WimHager/Kedok/Docs/Wireing-Unit.png

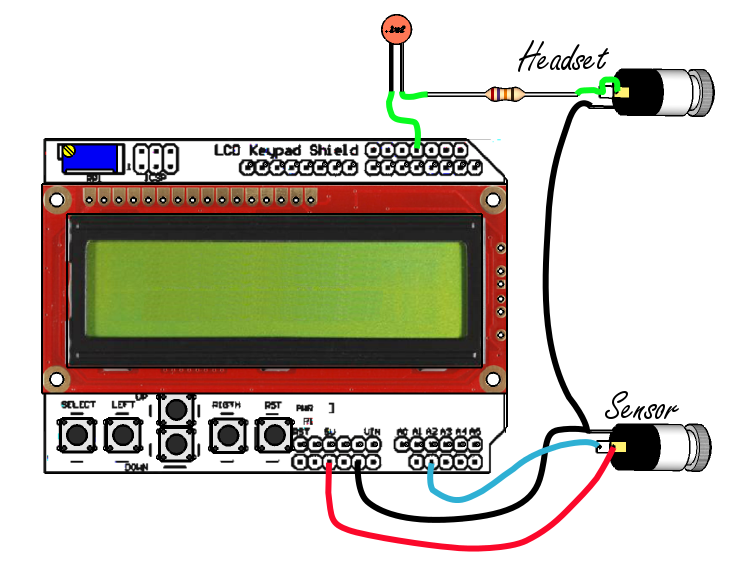
Docs/Wireing-Unit.png
