WimHager/Kedok/CAD/Lamp Laser Adjuster/LaserCap.jpg

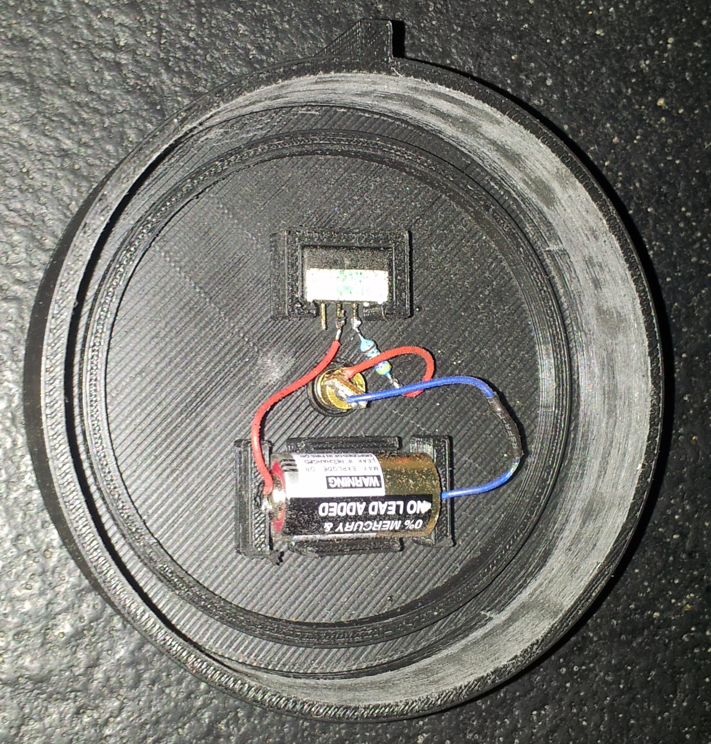
CAD/Lamp Laser Adjuster/LaserCap.jpg
