WimHager/Kedok/README.md

# Kedok
Audio aiming device
Kedok a device to build an acoustical aiming scope for visual impaired sport shooters, better known as the SH3 class. 
http://acoustic-shooting.blogspot.nl
