WimHager/Kedok/CAD/Lamp Laser Adjuster/Cap on lamp.jpg

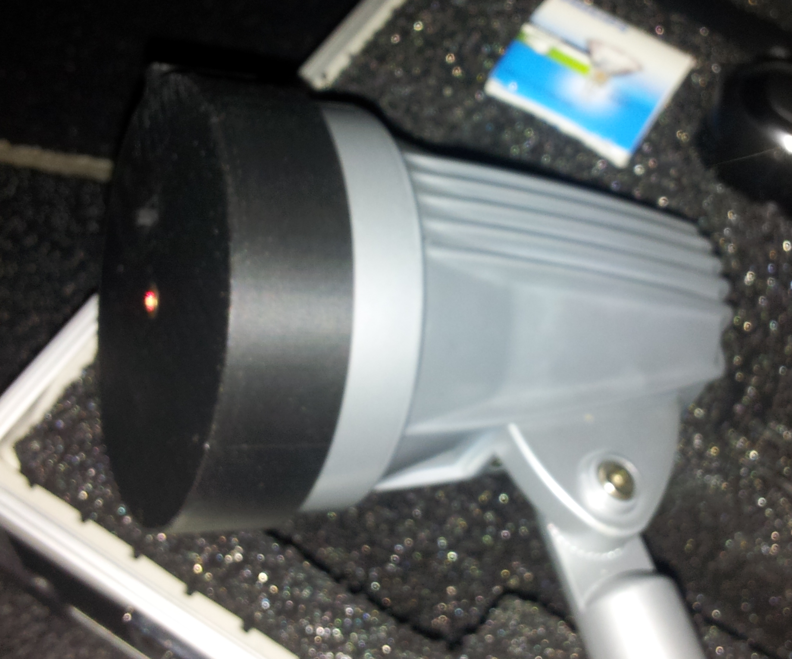
CAD/Lamp Laser Adjuster/Cap on lamp.jpg
