WimHager/Kedok/CAD/Lamp Laser Adjuster/Laser Cap.png

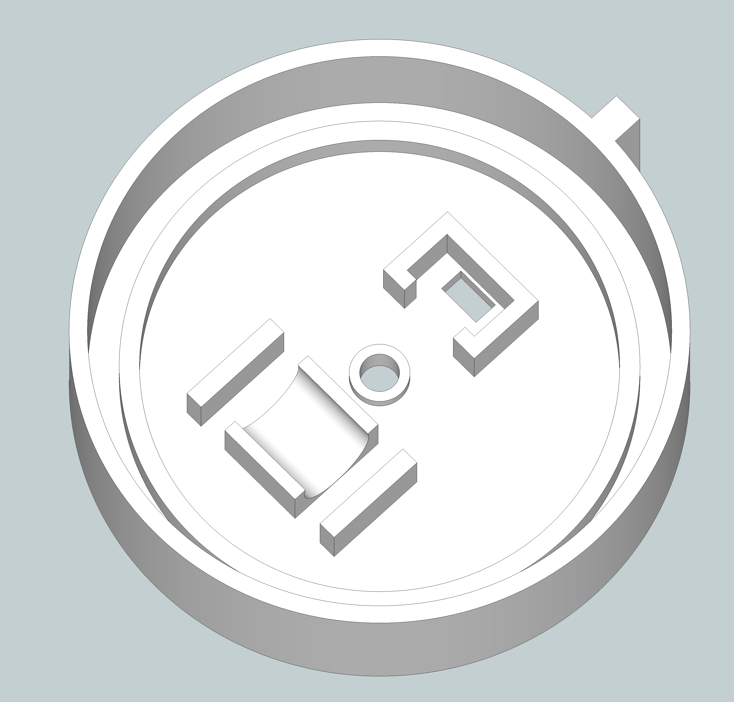
CAD/Lamp Laser Adjuster/Laser Cap.png
