WimHager/Kedok/Docs/Scope iso view.png

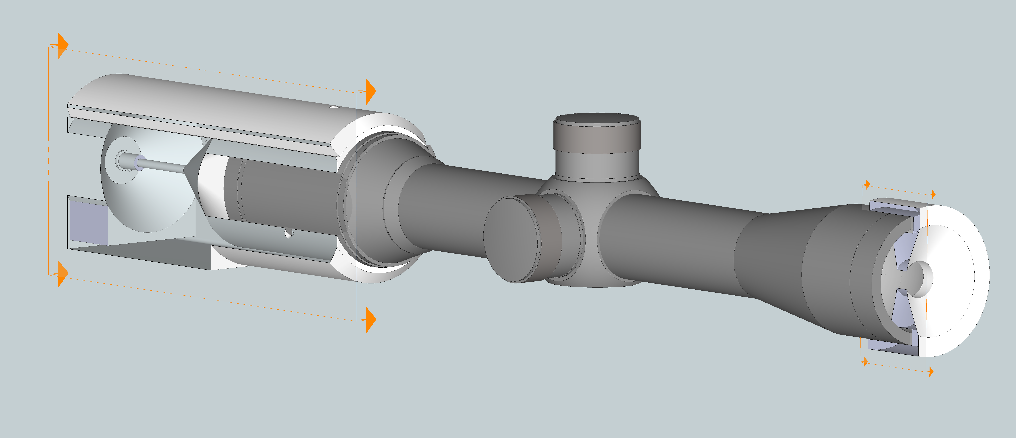
Docs/Scope iso view.png
