WimHager/Kedok/Docs/Unit 800.png

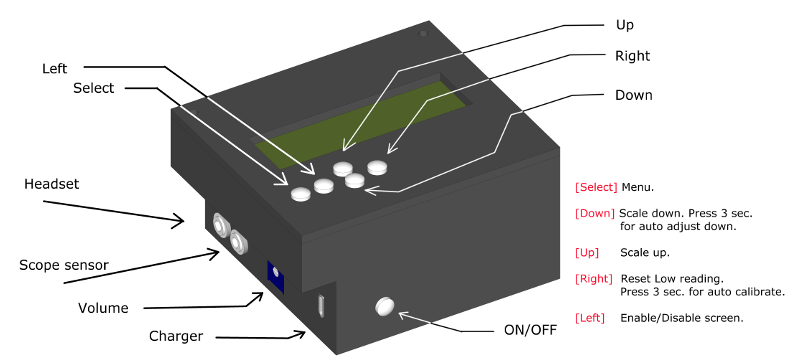
Docs/Unit 800.png
