WimHager/Kedok/Docs/Wireing-Adaptor..png

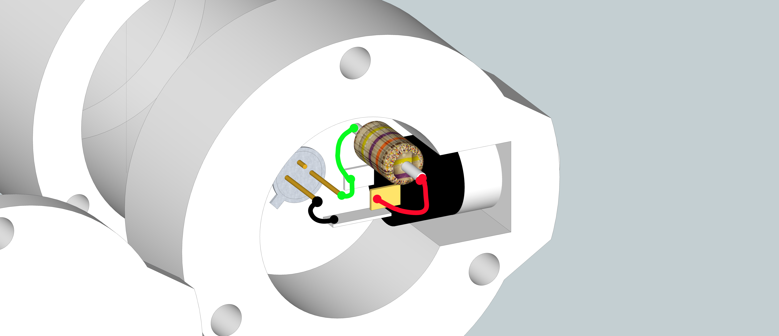
Docs/Wireing-Adaptor..png
