WimHager/Kedok/CAD/Housing/STL/Buttons top.stl

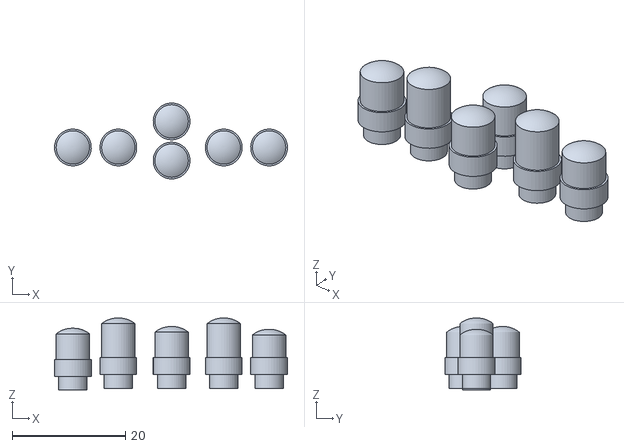
[picture p8: CAD file, 2015-12-07]
CAD/Housing/STL/Buttons top.stl
41.1 x 13.4 x 12.7
