WimHager/Kedok/CAD/Scope Adaptor/Hawke 4x32/STL/HawkeAdaptor 2.00 Vantage Tube.stl

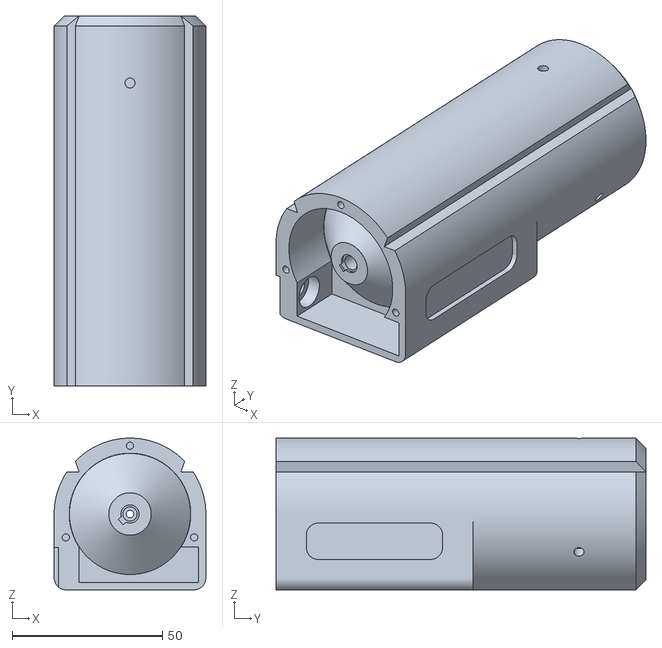
[picture p9: CAD file, 2015-12-10]
CAD/Scope Adaptor/Hawke 4x32/STL/HawkeAdaptor 2.00 Vantage Tube.stl
50.5 x 123.0 x 50.5
