WimHager/Kedok/CAD/Housing/STL/Bottom.stl

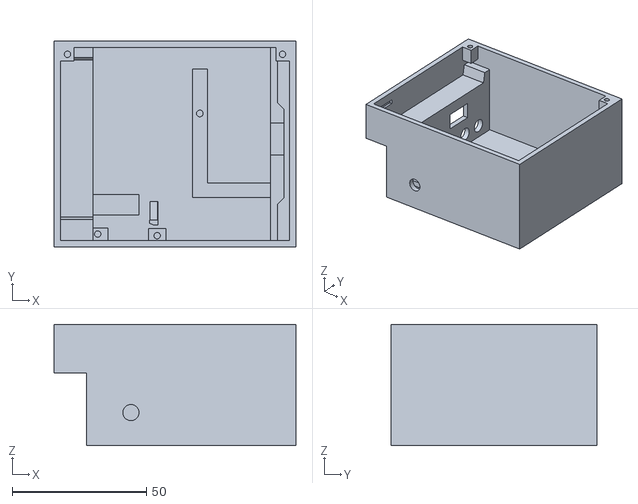
[picture p10: CAD file, 2015-12-07]
CAD/Housing/STL/Bottom.stl
90.0 x 76.7 x 45.1
