WimHager/Kedok/CAD/Scope Adaptor/Hawke 4x32/STL/HawkeAdaptor 2.00 Vantage Back Cap.stl

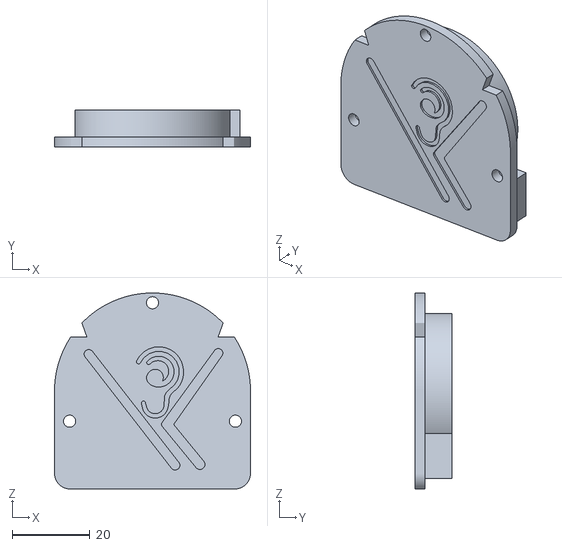
[picture p11: CAD file, 2015-12-10]
CAD/Scope Adaptor/Hawke 4x32/STL/HawkeAdaptor 2.00 Vantage Back Cap.stl
50.5 x 9.53 x 50.5
