WimHager/Kedok/CAD/Housing/STL/Charger mount.stl

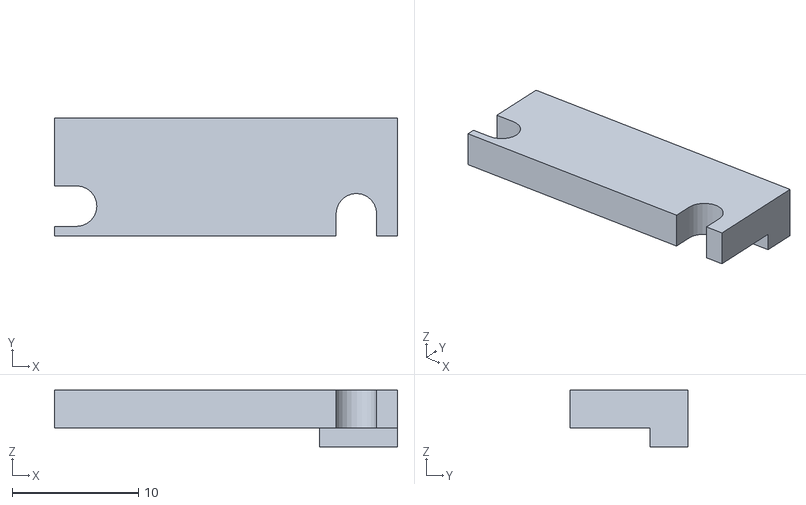
[picture p12: CAD file, 2015-12-07]
CAD/Housing/STL/Charger mount.stl
27.1 x 9.30 x 4.50
