WimHager/Kedok/CAD/Housing/STL/Top.stl

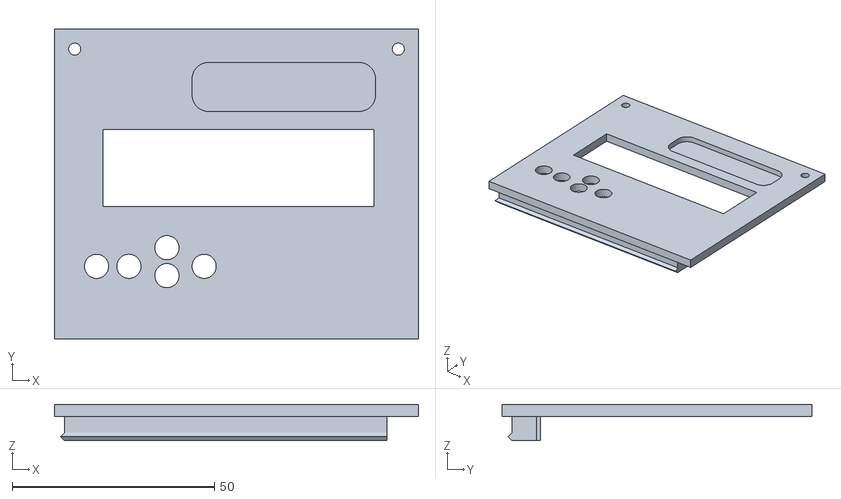
[picture p13: CAD file, 2015-12-07]
CAD/Housing/STL/Top.stl
90.0 x 76.7 x 9.00
