WimHager/Kedok/CAD/Housing/STL/Button on-off.stl

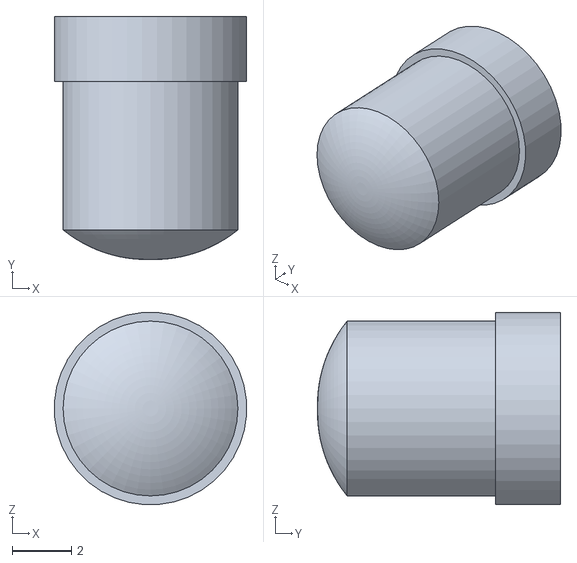
[picture p14: CAD file, 2015-12-07]
CAD/Housing/STL/Button on-off.stl
6.49 x 8.20 x 6.49
