WimHager/Kedok/CAD/Housing/STL/Programmer lid.stl

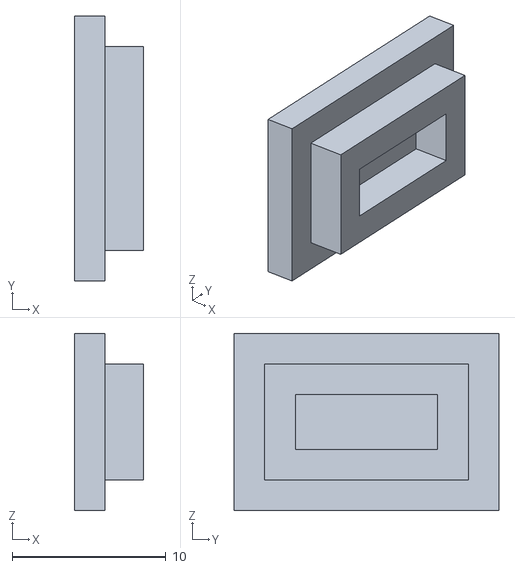
[picture p15: CAD file, 2015-12-07]
CAD/Housing/STL/Programmer lid.stl
4.50 x 17.2 x 11.6
