WimHager/Kedok/(list of files, cad)

Other CAD files:
CAD/Lamp Laser Adjuster/Laser Cap.skp
CAD/Scope Adaptor/Hawke 4x32/Hawke 4x32 Vantage.skp
CAD/Scope Adaptor/Hawke 4x32/HawkeAdaptor 2.00 Sport HD.skp
CAD/Scope Adaptor/Hawke 4x32/HawkeAdaptor 2.00 Vantage no logo.skp
CAD/Scope Adaptor/Hawke 4x32/HawkeAdaptor 2.00 Vantage.skp
CAD/Scope Adaptor/Hawke 4x32/HawkeAdaptor 2.00.skp
CAD/Scope Adaptor/Hawke 4x32/HawkeAdaptor Diaphragm Sport HD.skp
CAD/Scope Adaptor/Tasco 4x20/Adaptor 2.10 (oud model 4x20).skp
CAD/Scope Adaptor/Tasco 4x20/Adaptor 2.20.skp
CAD/Scope Adaptor/Tasco 4x20/ScopeAdjuster.skp
CAD/Suitcase/Inlay.skp
CAD/Tripod/LampMount.skp
CAD/Tripod/TrafoMount.skp
CAD/Tripod/TrafoMountVertical.skp
