WimHager/Kedok/Docs/Manual/Beschrijving van het Kedo kastje-5.0.odt

Beschrijving van de Kedok unit.

Het kastje heeft een afmeting van 10 bij 7 bij 5 centimeters.

Wat er op de bovenkant zit:

In het midden zit een LCD scherm en er zitten 5 knoppen aan de linker onderzijde.

Met de meest linkse knop komt in in het menu voor de instellingen.

Rechts hiervan zit de knop om de scherm updates uit of aan te zetten.

Hiernaast zitten twee knoppen Up en Down, met deze knoppen kunt het venster waarin de sensor werkt verlagen of verhogen.

De meest rechtse knop is om de laagste waarde in het scherm te resetten, druk je 3 seconden op de knop dan start het automatisch kalibreren.

Aan de voorzijde zit maar één knop voor aan en uit, als je het kastje aan zet zul je een melodie horen.

Linker kant:

Van voor naar achteren, de eerste aansluiting is een mini USB aansluiting om de accu op te laden.

Hierachter zit een klein vierkant, hiermee kun je het volume regelen. Dit kun je bedienen met een kleine schroevendraaier of met je nagel.

Vervolgens zit hierachter een 3,5mm jack plug voor de sensor kabel.

De laatste aansluiting is eveneens een 3,5mm jack plug voor de koptelefoon.

En ja, ik weet dat een LCD scherm geen enkel nut heeft voor iemand die niet kan zien. Maar zit daar niet over in, je hebt het niet nodig.
