WimHager/Kedok/Docs/Manual/Description of the Kedok unit-5.0.odt

Description of the Kedok unit.

The unit is a box with a size of 10 by 7 by 5 centimetres

What you can find on the top of the box:

There is a LCD display at the centre.

And you have 5 buttons, at the left bottom.

The most left button is to enter the menu for settings.

Right next button is used to enable or disable the LCD screen sensor reading updates.

Then there are two buttons Up and down. these buttons are used to increase or decrease the sensor reading.

The most right button is to reset the lowest reading in the display.

If you press this button for 3 seconds, automatic calibration of the unit starts.

The front:

There is only one button to switch the unit on and off, if you switch it on you will hear a melody.

Left side:

Reading it from front to back.

First there is a mini USB connector for charging the unit battery.

Behind this is a small square here you can set the unit volume, use a small screwdriver or you nail to adjust.

Next there is a 3.5mm jack connector for the sensor cable.

The last one is also a 3.5mm jack for the headphones.

And yes I know, a LCD display makes no sense if you can't see, but don't worry you won't need it.
