WimHager/Kedok/Docs/Tripot setup.png

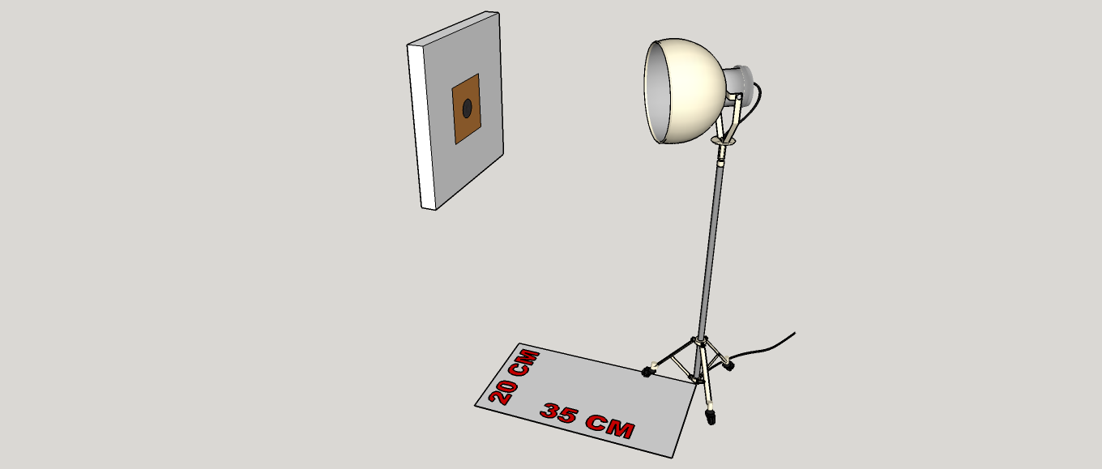
Docs/Tripot setup.png
