WimHager/Kedok/Software/Dev/Kedok-V3.3.ino

/*
    Kedok (audio aiming device), Copyright 2015 Wim Hager
    Kedok is distributed under the terms of the GNU GPL
    
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
    12/6/2015 This software is started by Wim Hager email: wim@mowbot.nl
              CAD and 3D printworks Jan Stinissen

To Do:
 Battery level check?
 ShowLCD bug. no clear
 Reset all if version updated
 Better Auto adjust
 Full test of Curve parameter
 Tons of testing for the new DDS module
 //Rollback from 3v3 mod. Does not work well with LCD keypad output on A0
 //No need to save logmode in eeprom
 //Logmode in display Only in No Display mode
 //Reverse Pitch
 //Save Setting as structure???
 //Always Sound. Added not tested yet!!
 //Removed "Always sound" no-one liked it.
 //new inrange for bar reading
 //Better way to find the target card. Idea:  if sensor-read < Min + 2 x Windowsize set sensor window twice the size
 //SetSensorWindowToLowestRead()
 //Make WordToStr better so it fits all sizes
 //Bug. while adjusting the MIN or UP parameter while shooting screen dos not return to running if Display is off.
 //Menu option to set auto adjust window, Benjamin prefers a window of 100 and a gain of -3
 //Test if gain is reverse. Negative etting gives a positve gain. 
 //Sound during auto adjust wait.
 //More info if display readings. Sensor Min Max Lowest
 //Auto adjust auto stop if no lower reading  within 12 sec.
 //Show settings instead of Running ... if displaymode is off
 //Logging
 
 V2.00 18-4-2015
 Compiled with 1.0.5
 New: Using NewTone Library
 25-4-2015 Changed defaults for high low tone
 V2.10 27-4-2015
 27-4-2015 Added shift sensor window while running Up/Down key
 29-4-2015 Speed up the main loop by one readkey.
 V3.00 3-5-2015
 Added Auto adjust
 New Beep and Keypressed function
 23-5-2015 Added some text in Auto adjust
 V3.1 26-6-2015
 Gain is replaced by Curve for better understanding.
 Added Auto adjust window size. Default 200
 28-7-2015  Made SensorPin a variable
 30-7-2015  Added option to enable Always sound
 1-9-2015   Always sound bug, was not set in menu
 24-10-2015 Screen bug update in no Dispaly mode
 26-10-2015 Removed cracking sound aiming near bulls-eye (removed inrange low value check)
 28-10-2015 Window Dec Inc set to 10
 28-10-2015 Redo of show status screen if display is disabled.
 31-10-2015 Added Owner name, shown when booting.
 02-11-2015 Added auto set Min value with a warning by pressing 3 sec down key
 V3.2 04-11-2015
 06-11-2015 New Kernel for better target card find
 06-11-2015 Removed Always sound, no-one liked it.
 14-11-2015 Added Logging.
 14-11-2015 Added Reverse Pitch
 14-11-2015 EE-Prom settings are saved as a Struct obj now
 25-11-2015 Compiled with 1.6.5 now
 28-11-2015 Roll back:  Added option to use 3.3V ref for optosensor. Enabled if data pin 0 is grounded.
 V3.3 04-12-2015
 04-12-2012 Added code for DDS 8950 chip as compiler option.
 */

//Note Audio pin 3, 82 Ohm and 470N in serie
//Opto resistor 68K
//Loops free running 4150 with sound 925

//#define DEBUG
#define DDS8950

#include <LiquidCrystal.h>
#ifdef DDS8950
  #include <DDS.h> 
#else   
  #include <NewTone.h>
#endif  
#include <EEPROM.h>
#include <LcdBarGraph.h>
LiquidCrystal lcd(8, 9, 4, 5, 6, 7);
LcdBarGraph   lbg(&lcd, 16, 0, 0);
int Melody[] = { 
  262, 196, 196, 220, 196, 0, 247, 262 };
int NoteDurations[] = { 
  4, 8, 8, 4, 4, 4, 4, 4 };
  
 struct SettingsObj {
  word MinValue;
  word MaxValue;
  byte ThresholdWindow;
  byte Curve;
  byte PitchRev;
  word AutoAdjustWindow;
  word LowTone;
  word HighTone;
  byte NotInUse;
  byte Display;
};  

const   char      Version[5]="3.30";
const   char      Owner[10]=     "";
const   byte      None=           0; 
const   byte      Select=         1;
const   byte      Left=           2;
const   byte      Down=           3;
const   byte      DownLong=      13;
const   byte      Up=             4; 
const   byte      Right=          5;
const   byte      RightLong=     15;
const   byte      Value=          1;
const   byte      Bar=            2;
const   boolean   Disable=     true;
const   boolean   Enable=     false;
const   char      EmptyLine[17]=  "                ";

#ifdef DDS8950 
 const int        W_CLK=  0;       // Pin 0 - connect to AD9850 module word load clock pin (CLK)
 const int        FQ_UD=  1;       // Pin 1 - connect to freq update pin (FQ)
 const int        DATA=   2;       // Pin 2 - connect to serial data load pin (DATA)
 const int        RESET=  3;       // Pin 3 - connect to reset pin (RST).
 DDS dds(W_CLK, FQ_UD, DATA, RESET);
#endif
  
word    MinValue=                100;
word    MaxValue=                800;
word    LowTone=                 100; 
word    HighTone=               1750;
byte    Curve=                     0;
byte    PitchRev=              false;  
word    AutoAdjustWindow=        200;
word    DispUpdTime=            1000; //1 sec Screen update 
byte    Display=                   0;
byte    ThresholdWindow=         150;
byte    LogMode=                   0;
word    LogCounter=                0;
byte    NotInUse=                  0; //For future use
byte    LogBufferStart=           30; 
word    LogUpdTime=              250; //4 times a second for 1000 values about 4 Min. logging 
byte    ResetAll=                  0;
byte    AudioPin=                  3;
byte    SensorPin=                A1;
word    AutoAdjustGetReadyTime= 2000; // 20 Seconds
char    *DisplayType[]= {"None", "Value",  "Bar"};
char    *YesNoArr[]=    {"N", "Y"};
char    *LoggingModes[]={"Off", "On", "Play"};

long    PrevDispTime;
long    PrevLogTime;
word    Reading;
word    AudioTone;
word    LowestReading;
word    WarningReading;
byte    KeyPressed;

//Debug params
#ifdef DEBUG
word    LoopCounter; 
#endif  

float fscale( float originalMin, float originalMax, float newBegin, float newEnd, float inputValue, float Curve){
  float   OriginalRange=    0;
  float   NewRange=         0;
  float   zeroRefCurVal=    0;
  float   normalizedCurVal= 0;
  float   rangedValue=      0;
  boolean invFlag=          0;

  Curve= 0-Curve; //Make Curve negative
  Curve= (Curve * -.1) ; 
  Curve= pow(10, Curve);
  if (inputValue < originalMin) inputValue= originalMin;
  if (inputValue > originalMax) inputValue = originalMax;
  OriginalRange = originalMax - originalMin;
  if (newEnd > newBegin) NewRange= newEnd - newBegin;
  else{
    NewRange= newBegin - newEnd; 
    invFlag= 1;
  }
  zeroRefCurVal= inputValue - originalMin;
  normalizedCurVal=  zeroRefCurVal / OriginalRange;  
  if (originalMin > originalMax ) return 0;
  if (invFlag == 0) rangedValue=  (pow(normalizedCurVal, Curve) * NewRange) + newBegin;
  else rangedValue=  newBegin - (pow(normalizedCurVal, Curve) * NewRange); 
  return rangedValue;
}

void Reset() {
  asm volatile ("  jmp 0");
}  

word ReadValue() {
  return analogRead(SensorPin);
}

void PlayTone(word Pitch, word Duration) {
  #ifdef DDS8950
     if (Duration > 0) {
        dds.setFrequency(Pitch);
        delay(Duration);
        dds.setFrequency(0);
     }else dds.setFrequency(Pitch);   
  #else
     if (Pitch > 0) NewTone(AudioPin, Pitch, Duration);
     else noNewTone(AudioPin);  
  #endif   
}

void Beep(byte Beeps, word Tone) {
  for (byte X=0; X<Beeps; X++) {
    PlayTone(Tone,200);
    delay(400);
  }
}

void PlayMelody() {
  for (int ThisNote= 0; ThisNote < 8; ThisNote++) {
    int NoteDuration = 1000/NoteDurations[ThisNote];
    #ifdef DDS8950
      PlayTone(Melody[ThisNote]*5, NoteDuration); // Play thisNote at full volume for noteDuration in the background.
    #else  
      PlayTone(Melody[ThisNote], NoteDuration);
    #endif   
    delay(NoteDuration * 4 / 3); // Wait while the tone plays in the background, plus another 33% delay between notes.
  }
}

void LowReadWarning() {
    PlayTone(0,0); // Turn off the tone.
    WarningReading= Reading;
    lcd.clear();
    ShowLCD("Lower Min Value!",0,true);
    Beep(3,300);
    if (!Display) ShowStatusLCD();
}  

String WordToStr(word Inp, byte Size) {
  String Str;
  for (byte C= 0; C<Size; C++) Str+= "0";
  String WordStr= (String)Inp;
  byte Len= WordStr.length();
  for (byte C= 0; C<Len; C++) Str[C+Str.length()-Len]= WordStr[C];
  return Str; 
}  

boolean InRange() {
  return ((Reading > MinValue) && (Reading < MaxValue));
}

void StopLogging() {
   LogMode= 0;
   LogCounter= 0;
   lcd.clear();
   ShowLCD("Loggin stopped.",0,true);
   Beep(2,300);
   if (!Display) ShowStatusLCD();
}  

void WriteLog(word Value) {
  if ((millis()-PrevLogTime) > LogUpdTime) {
    if (LogCounter < 1000) {
       EEPROM.update(LogCounter+LogBufferStart, map(Value, MinValue, MaxValue, 0, 255));
       LogCounter++;
       PrevLogTime= millis();
    }else StopLogging();
  }  
 }  

void OutputLog() {
  for (int C= 20; C<1000; C++) { 
    Serial.println(EEPROM.read(C));
  }
  StopLogging();
}  

void MoveSensorWindow(int Val) {
  MinValue= MinValue + Val;
  MaxValue= MaxValue + Val;
  Beep(2,300);
  ShowLCD("Settings saved..",0, true);
  ShowLCD("Min "+(String)MinValue+" Max "+(String)MaxValue, 1, true);
  WriteConfig();
  delay(3000);
  if (!Display) ShowStatusLCD();
}  

void MoveSensorWindowToLowestRead() {
  word SensorWindow= MaxValue - MinValue;
  MinValue= WarningReading-10;
  MaxValue= MinValue+SensorWindow;
  Beep(2,300);
  ShowLCD("Settings saved..",0, true);
  ShowLCD("Min "+(String)MinValue+" Max "+(String)MaxValue, 1, true);
  WriteConfig();
  delay(3000);
  if (!Display) ShowStatusLCD();
}  

void ShowLCD(String Text, byte Line, boolean Clear) {
  lcd.setCursor(0, Line);
  lcd.print(EmptyLine);
  lcd.setCursor(0, Line);
  lcd.print(Text);
}

void ShowBar(byte Len) {
  lcd.clear();
  lbg.drawValue(Len, 160);
  ShowLCD((String)map(Len,0,160,0,10),2,true);
} 

void Screen(boolean Dis) {
  if (Dis) {
    Display= None;
    lcd.clear();
    ShowStatusLCD();
  }
  else Display= 1;
  delay(500); 
}

void ShowValues() {
  #ifdef DEBUG
    ShowLCD("Sen:"+WordToStr(Reading,4)+ " L:"+WordToStr(LoopCounter,5),0, true);
    LoopCounter= 0;
  #else  
    ShowLCD("Sen:"+WordToStr(Reading,4)+ " Low:"+WordToStr(LowestReading,3),0, true);
  #endif  
  ShowLCD("Min:"+WordToStr(MinValue,4)+" Max:"+WordToStr(MaxValue,3),1, true);
} 

void ShowStatusLCD() {
  if (LogMode) ShowLCD("Running..      *",0, false);
  else ShowLCD("Running..",0, false);
  ShowLCD("L:"+WordToStr(MinValue,3)+" H:"+WordToStr(MaxValue,3)+" C:"+WordToStr(Curve,2),1, true);
}  

void WriteConfig() {
  SettingsObj CurSettings= {
    MinValue,
    MaxValue,
    ThresholdWindow,
    Curve,
    PitchRev,
    AutoAdjustWindow,
    LowTone,
    HighTone,
    LogMode,
    Display
  };  
  EEPROM.put(1, CurSettings);
  EEPROM.write(0,1);
} 

void ReadConfig() {
  ShowLCD("Read Config...",0, true);
  SettingsObj CurSettings;
  EEPROM.get(1, CurSettings); //Read all settings
  MinValue= CurSettings.MinValue;
  MaxValue= CurSettings.MaxValue;
  ThresholdWindow= CurSettings.ThresholdWindow;
  Curve= CurSettings.Curve;
  PitchRev= CurSettings.PitchRev;
  AutoAdjustWindow= CurSettings.AutoAdjustWindow;
  LowTone= CurSettings.LowTone;
  HighTone= CurSettings.HighTone;
  NotInUse= CurSettings.NotInUse;
  Display= CurSettings.Display;
}

void EEPromClear() {
  for (int I = 0; I < 1023; I++) EEPROM.write(I, 0);
}

void AutoAdjust() {
  word Reading;
  word LowestReading= 1023;
  word TimeOutCounter=   0;
  lcd.clear();
  ShowLCD("Auto Adjust.", 0, true);
  ShowLCD("Get ready.", 1, true);
  //ShowLCD((String)TimeOutCounter, 1, true);
  while (TimeOutCounter < AutoAdjustGetReadyTime) {
    Reading= ReadValue();
    AudioTone= fscale(100,900,HighTone,LowTone,Reading,Curve);
    PlayTone(AudioTone,0);
    TimeOutCounter++;
    delay(10);
  }
  delay(300); 
  Beep(1,2000); 
  delay(300);
  ShowLCD("Aim at target.", 1, true);
  TimeOutCounter= 0;
  while (ReadKey() == None) {
    Reading= ReadValue();
    AudioTone= fscale(100,900,HighTone,LowTone,Reading,Curve);
    PlayTone(AudioTone, 0);
    if (Reading < LowestReading) {
      LowestReading= Reading;
      TimeOutCounter= 0;
    }  
    TimeOutCounter++;
    if (TimeOutCounter > 2000) break;
    delay(10);
  }
  if (LowestReading < 820) {
    Beep(3,2000);
    MinValue= LowestReading-20;
    MaxValue= MinValue+AutoAdjustWindow;
    ShowLCD("Config saved", 0, true);
    ShowLCD("Min "+(String)MinValue+" Max "+(String)MaxValue, 1, true);
    WriteConfig();
    delay(3000);
  }
  else Beep(6,100);
  lcd.clear();
  if (!Display)ShowStatusLCD(); 
} 

byte KeyVal() {
  word KeyVal= analogRead(0);
  //ShowLCD("KeyVal: "+(String)KeyVal,0, true);
  //delay(2000);
  if (KeyVal > 900)  return 0; //None     todo change code to map function
  if (KeyVal > 600)  return 1; //Select
  if (KeyVal > 400)  return 2; //Left
  if (KeyVal > 200)  return 3; //Down
  if (KeyVal > 80 )  return 4; //Up
  return                    5; //Right
}  

byte ReadKey() {
  byte LongPressed= 0;
  word KeyPressCounter= 0;
  byte Key= KeyVal();
  if (Key) {
    while (Key == KeyVal()) {
      KeyPressCounter++;
      if (KeyPressCounter > 15000) {
        Beep(2,600);
        Key= Key+10;
        break;  
      }
    }
  }
  return Key;
}  

void Menu() {
  PlayTone(0,0); //Turn off sound
  ShowLCD("Settings",0, true);
  boolean Esc= false;
  while (!Esc) {
    ShowLCD("MIN: "+(String)MinValue, 1, true);
    if (KeyVal() == Down)   if (MinValue > 10) MinValue-= 5;
    if (KeyVal() == Up)     if (MinValue < (MaxValue-20)) MinValue+= 5;
    if (KeyVal() == Select) Esc= true;
    delay(300);
  } 
  Esc= false; 
  while (!Esc) {
    ShowLCD("MAX: "+(String)MaxValue, 1, true);
    delay(300);
    if (KeyVal() == Down)   if (MaxValue > (MinValue+20)) MaxValue-= 5;
    if (KeyVal() == Up)     if (MaxValue < 990) MaxValue+= 5;
    if (KeyVal() == Select) Esc= true;
  }
  Esc= false; 
  while (!Esc) {
    ShowLCD("Threshold: "+(String)ThresholdWindow, 1, true);
    delay(300);
    if (KeyVal() == Down)   if (ThresholdWindow > 10)  ThresholdWindow-= 10;
    if (KeyVal() == Up)     if (ThresholdWindow < 190) ThresholdWindow+= 10;
    if (KeyVal() == Select) Esc= true;
  }
  Esc= false;   
  while (!Esc) {
    ShowLCD("Curve: "+(String)Curve, 1, true);
    delay(300);
    if (KeyVal() == Down)   if (Curve > 0) Curve--;
    if (KeyVal() == Up)     if (Curve < 5) Curve++;
    if (KeyVal() == Select) Esc= true;
  }
  Esc= false;   
  while (!Esc) {
    ShowLCD("Pitch rev: "+(String)YesNoArr[PitchRev], 1, true);
    delay(300);
    if (KeyVal() == Down)   if (PitchRev > 0) PitchRev--;
    if (KeyVal() == Up)     if (PitchRev < 1) PitchRev++;
    if (KeyVal() == Select) Esc= true;
  }
  Esc= false;   
  while (!Esc) {
    ShowLCD("AutoWindow: "+(String)AutoAdjustWindow, 1, true);
    delay(300);
    if (KeyVal() == Down)   if (AutoAdjustWindow > 50)   AutoAdjustWindow-= 10;
    if (KeyVal() == Up)     if (AutoAdjustWindow < 300)  AutoAdjustWindow+= 10;
    if (KeyVal() == Select) Esc= true;
  }  
  Esc= false;
  while (!Esc) {
    ShowLCD("LowTone: "+(String)LowTone, 1, true);
    PlayTone(LowTone, 0);
    delay(300);
    if (KeyVal() == Down)   if (LowTone > 50) LowTone-= 50;
    if (KeyVal() == Up)     if (LowTone < (HighTone-100)) LowTone+= 50;
    if (KeyVal() == Select) Esc= true;
  } 
  Esc= false; 
  PlayTone(0,0);
  while (!Esc) {
    ShowLCD("HighTone: "+(String)HighTone, 1, true);
    PlayTone(HighTone,0);
    delay(300);
    if (KeyVal() == Down)   if (HighTone > (LowTone+100)) HighTone-= 50;
    if (KeyVal() == Up)     if (HighTone < 9000) HighTone+= 50;
    if (KeyVal() == Select) Esc= true;
  }
  Esc= false;
  PlayTone(0,0);
  Display=  EEPROM.read(15); //read value from rom setting instead of global  
  while (!Esc) {
    ShowLCD("Display: "+(String)DisplayType[Display], 1, true);
    delay(300);
    if (KeyVal() == Down)   if (Display > 0) Display--;
    if (KeyVal() == Up)     if (Display < 2) Display++;
    if (KeyVal() == Select) Esc= true;
  }
  Esc= false;
  while (!Esc) {
    ShowLCD("Logging: "+(String)LoggingModes[LogMode], 1, true);
    delay(300);
    if (KeyVal() == Down)   if (LogMode > 0) LogMode--;
    if (KeyVal() == Up)     if (LogMode < 2) LogMode++;
    if (KeyVal() == Select) Esc= true;
  }
  Esc= false;   
  while (!Esc) {
    ShowLCD("Reset ALL: "+(String)YesNoArr[ResetAll], 1, true);
    delay(300);
    if (KeyVal() == Down)   if (ResetAll > 0) ResetAll--;
    if (KeyVal() == Up)     if (ResetAll < 1) ResetAll++;
    if (KeyVal() == Select) Esc= true;
  }
  if (ResetAll) { 
    EEPROM.write(0,0); 
    Reset(); 
  }
  if (LogMode==2) OutputLog();
  if (LogMode==1) LogCounter= 0;  
  WriteConfig();
  ShowLCD("Saved......",1,true);
  delay(3000);
  lcd.clear();
  if (!Display) ShowStatusLCD(); 
} 

void setup() {
  pinMode(A1, INPUT);
  lcd.begin(16, 2);
  #ifdef DDS8950
     dds.init();  
     //dds.trim(125000000); // enter actual osc freq
  #endif  
  ShowLCD("Kedok "+(String)Version,0, true);
  ShowLCD(Owner,1, false);
  delay(1000);
  ShowLCD("Starting...",0, true);
  delay(500);
  if (EEPROM.read(0)==1) ReadConfig();
  else WriteConfig();
  delay(1000);
  Serial.begin(9600);
  PrevDispTime= millis();
  PrevLogTime= millis();
  LowestReading= MaxValue;
  WarningReading= MinValue;
  if (!Display) ShowStatusLCD();
  PlayMelody();
}

void loop() {
  Reading= ReadValue();
  if (Display) {
    if ((millis()-PrevDispTime) > DispUpdTime) {
      if (Display == Value) ShowValues();
      if (Display == Bar) if (InRange()) ShowBar(map(Reading,MinValue,MaxValue,160,0));
      else ShowBar(2);
      PrevDispTime= millis();
    }
  } 
  
 //--------Kernel part-------- 
  if (Reading < MinValue) {
     LowReadWarning(); 
  }else if (Reading < MaxValue) {
     if (PitchRev) AudioTone= fscale(MinValue,MaxValue,LowTone,HighTone,Reading,Curve);
     else AudioTone= fscale(MinValue,MaxValue,HighTone,LowTone,Reading,Curve);
     PlayTone(AudioTone, 0);
     if (LogMode) WriteLog(Reading);
  }else if (Reading < (MaxValue+ThresholdWindow)) {
     if (PitchRev) PlayTone(HighTone + 200, 0);
     else PlayTone(LowTone-30, 0);  
  }else PlayTone(0,0); // Turn off the tone. 
//-----------------

  if (Reading < LowestReading) LowestReading= Reading; 
  
  KeyPressed= ReadKey();
  if (KeyPressed) {  
    if (KeyPressed == Select)    Menu();
    if (KeyPressed == Right)     LowestReading= MaxValue;
    if (KeyPressed == RightLong) AutoAdjust();
    if (KeyPressed == Left)      if (Display) Screen(Disable); else Screen(Enable);
    if (KeyPressed == Down)      MoveSensorWindow(-10);
    if (KeyPressed == DownLong)  MoveSensorWindowToLowestRead();
    if (KeyPressed == Up)        MoveSensorWindow(+10);
  }
  #ifdef DDS8950
    delay(20);
  #endif  
  #ifdef DEBUG
    LoopCounter++;
  #endif  
}
