WimHager/Kedok/(commit log)

2015-06-15 Added wirering
2015-06-15 Updated wireing
2015-06-20 New wire drawing Adaptor and renamed a file
2015-07-07 Bug in auto adjust window set
    [Kedok-V3.1.ino]
2015-07-24 Added Cad works and Logo
    [Adaptor 2.10.skp, LampMount.skp]
2015-07-25 Update scope adaptor for M4 screw nuts
    [Adaptor 2.10 (oud model 4x20).skp, Adaptor 2.10.skp, Adaptor 2.20.skp]
2015-08-03 Added extra cad works
    [ScopeAdjuster.skp, TrafoMount.skp, TrafoMountVertical.skp]
2015-08-08 Added suitcase inlay
    [Inlay.skp]
2015-08-11 Added laser adjuster for Lamp
    [Laser Cap.skp]
2015-09-01 Always sound bug, was not set in menu
    [Kedok-V3.1.ino]
2015-09-13 Added adaptor for Hawke 4x32
    [Adaptor 2.10 (oud model 4x20).skp, Adaptor 2.20.skp, HawkeAdaptor 2.02.skp, ScopeAdjuster.skp]
2015-09-26 Updated CAD works for Hawke
    [Hawke 4x32 scope.skp, HawkeAdaptor 2.02.skp, HawkeAdaptor 2.10.skp]
2015-10-01 Updated CAD works
    [Adaptor 2.20.skp, HawkeAdaptor 1.00 ring.skp, HawkeAdaptor 1.00.skp, HawkeAdaptor 2.00 no logo.skp, HawkeAdaptor 2.00.skp, HawkeAdaptor 2.10.skp]
2015-10-13 Bug list software update and removed old drawings for Hawke
    [HawkeAdaptor 1.00 ring.skp, HawkeAdaptor 1.00.skp]
2015-10-17 Added Diaphragm ring
    [HawkeAdaptor Diaphragm.skp]
2015-10-20 Killed a minor display update bug
    Bug. while adjusting the MIN or UP parameter while shooting screen dos
    not return to running if Display is off.
    [Kedok-V3.1.ino]
2015-10-23 CAD works cleanup
    [Hawke 4x32 Vantage.skp, HawkeAdaptor 2.00 Sport HD.skp, HawkeAdaptor 2.00 Vantage no logo.skp, HawkeAdaptor 2.00 Vantage.skp, HawkeAdaptor Diaphragm Sport HD.skp]
2015-10-26 Removed cracking sound aiming near bulls-eye (removed inrange low value check)
    [Kedok-V3.1.ino]
2015-11-14 Added reverse pitch, Code optimize
    Reverse Pitch is now possible and better code for EEprom adresses
2015-11-16 Finished reverse pitch
2015-11-30 Rollback from 3v3 mod. Does not work well with LCD keypad output on A0
    Since the LCD keypad runs on a 5V ref for AD conversion it's buggy to
    use a 3V3 ref.
2015-12-07 Added STL files
    [Bottom.stl, Button on-off.stl, Buttons top.stl, Charger mount.stl, Programmer lid.stl, Top.stl]
2015-12-10 Added scope adaptor STL files
    [HawkeAdaptor 2.00 Vantage Back Cap.stl, HawkeAdaptor 2.00 Vantage Tube.stl]
2016-01-01 Moved v3.3 to the stable branch. Started new development for V4.00 DDS
    Don't try v4.00 yet it's not working yet
    [DDS9833-Demo.ino, Kedok-V3.00.ino, Kedok-V3.20.ino]
2016-02-09 Added sensor average and Many code updating and cleaning
2016-04-09 Added three new options Average, Sample speed, Time out get ready is now a setting. Few bugs killed
    [Kedok-V5.00.ino]
2016-04-10 Added Dutch help functions for speech. killed a few bugs
    Todo English help files
    [Kedok-V5.00.ino]
2016-04-10 Fixed sample speed bug in menu
    [Kedok-V5.00.ino]
2016-04-10 Speech menu counter fix.
    [Kedok-V5.00.ino]
2016-04-12 Added an extra sample speed
2016-04-12 Sample speed fix
2016-04-21 Updated docs, some bux fixes
    [HawkeAdaptor 2.00.skp]
2016-05-30 Speech will say the pitch frequency too
2016-05-31 Sensor error will say value read now.
    [Kedok-V5.00.ino]
2017-02-13 Added i2C ADS1015
    Added code for ADS1015 ADC module in scope.
    For now in 10 bits mode and not tested yet
2017-06-06 Initisiated new Kedok 6.00 O-Led
    Major code update and cleaning, The new 6 will have both voice and
    screen.
    For old Voice and LCD kedoks there will be only bug fixing and minor
    updates.
    The Six will be Kedoks future.
    [Kedok-V6.00.ino]
2017-06-10 Added EMA filtering.
    Not tested yet
2017-06-11 Started with batt check
    First tests to check battery
2017-06-18 Optimize and cleaning code
    Also added voice for new filter
2017-06-26 Minor bug, only say value if saved in menu
    [Kedok-V6.00.ino]
2017-07-05 Added Test mode compiler directive
    SENSOR-TEST
2017-09-12 Started to code function for advanced users
    Not working yet
    [Kedok-V6.00.ino]
2017-09-12 Experianced user setting
    Not working yet.
    [Kedok-V6.00.ino]
2017-12-31 Added stance traner and adjustable pitch step
2018-03-18 More work on Sensor warning sensitivity
    Not ready yet
2018-03-18 Added option to set sensitivity level on Low sensor value
